Meticulous-Technologies/USB_VSense/TRADEMARK.md

# Trademark Policy

**Meticulous Technologies** and **USB VSense** are trademarks of Meticulous Technologies.

This repository offers open-source hardware and software. While the design files and source code are licensed under open-source licenses (CERN-OHL-S-2.0 and GPL-3.0-only), these licenses **do not** grant you the right to use our trademarks, trade names, or logos, except as required for reasonable attribution or as described below.

## 1. Permitted Use (Nominative Fair Use)
You may use the names "Meticulous Technologies" or "USB VSense" strictly to refer to this specific project or to describe the origin of a derivative work, provided that the use does not imply endorsement, affiliation, or sponsorship by Meticulous Technologies.

* **Allowed:** "This product is based on the USB VSense design by Meticulous Technologies."
* **Allowed:** "A fork of the USB VSense firmware."

## 2. Restricted Use (Forks and Commercial Products)
If you create a derivative work (modified hardware or software) or manufacture this design for sale:

1.  **You MUST NOT use the name "USB VSense"** as the primary name of your product. You must choose your own product name.
2.  **You MUST NOT use the "Meticulous Technologies" logo** or branding on your product, packaging, or marketing materials.
3.  **You MUST remove** the Meticulous Technologies logo and the "USB VSense" name from any physical products, software user interfaces, and marketing assets if you are distributing a modified version or a commercial product that is not authorized by us.

## 3. Manufacturing and Physical Goods
The design files in this repository (including but not limited to schematics, PCB layouts, and silkscreen / solder-mask artwork) may contain the Meticulous Technologies logo or the "USB VSense" name.

* **Personal Use:** If you manufacture these designs strictly for personal use, research, or study, you need not remove the trademarks.
* **Commercial Use:** If you manufacture these designs for sale or commercial distribution, you are **legally required to remove** all Meticulous Technologies logos and the "USB VSense" name from the physical object and the manufacturing files before production, unless you have obtained explicit written permission from us.

## 4. Third-Party Marks
The Gamma PCB artwork also contains a third-party PCB manufacturer's logo, which is not ours to license. The open-source licenses do not grant any right to it either. Remove it before manufacturing a derivative or commercial product unless you have the owner's permission.

## Summary
* **Code/Design:** Open for everyone (under CERN-OHL-S-2.0 / GPL-3.0-only).
* **Name/Brand:** Reserved for Meticulous Technologies.

If you have questions about using our marks, please contact us.
