Meticulous-Technologies/USB_VSense/firmware/MPLABX/usb_vsense_hw_gamma_fw_r1.X/queuelogs/debugtool.txt

755 1727157855812 GEN4_CONNECT_DIAGNOSTICS:MPLABCommTool is null

755 1727157855812 GEN4_TO_CONTROLLER_LOG:GEN4_CONNECT_INT_LOG_ATtiny406 Pre:GetFirmwareInfo
755 1727157855812 GEN4_TO_CONTROLLER_LOG:GEN4_CONNECT_INT_LOG_ATtiny406 Payload
755 1727157855812 GEN4_TO_CONTROLLER_LOG:GEN4_CONNECT_INT_LOG_ATtiny406 null
755 1727157855812 GEN4_TO_CONTROLLER_LOG:GEN4_CONNECT_INT_LOG_ATtiny406 Payload End
755 1727157855820 GEN4_TO_CONTROLLER_LOG:GEN4_CONNECT_INT_LOG_ATtiny406 Post:GetFirmwareInfo
755 1727157855820 GEN4_TO_CONTROLLER_LOG:GEN4_CONNECT_INT_LOG_ATtiny406 Return Value
755 1727157855820 GEN4_TO_CONTROLLER_LOG:GEN4_CONNECT_INT_LOG_ATtiny406 FirmwareInfo: Values:
755 1727157855820 GEN4_TO_CONTROLLER_LOG:GEN4_CONNECT_INT_LOG_ATtiny406 FirmwareInfo: boot = false, bootVer = 01.00.00, apVer = 02.01.35, fpgaVer = ff.ff.ff, scriptVer = 00.06.71, macAddress = 0495683578354564855485054485051, devID = a1020e01, devID1 = 2, devSN0 = ffffffff, devSN1 = ffffffff, serialNumber = BUR223271655, appCommitID = null, scriptCommitID = 74cdf38a4d, PCB_ID = 6
755 1727157855820 GEN4_TO_CONTROLLER_LOG:GEN4_CONNECT_INT_LOG_ATtiny406 Return End

755 1727157855820 GEN4_TO_CONTROLLER_LOG:GEN4_CONNECT_INT_LOG_ATtiny406 Pre:SetPowerInfo
755 1727157855820 GEN4_TO_CONTROLLER_LOG:GEN4_CONNECT_INT_LOG_ATtiny406 Payload
755 1727157855820 GEN4_TO_CONTROLLER_LOG:GEN4_CONNECT_INT_LOG_ATtiny406 PowerInfo: Values:
755 1727157855820 GEN4_TO_CONTROLLER_LOG:GEN4_CONNECT_INT_LOG_ATtiny406 PowerInfo: shotDownSystem = true, isToolPower = false, voltage = 0.000000, useVppFirst = false, useLowVoltageProgramming = true, useMaintainActivePower = false
755 1727157855820 GEN4_TO_CONTROLLER_LOG:GEN4_CONNECT_INT_LOG_ATtiny406 Payload End
755 1727157855820 XXXX 1727157855820, Thread 755: XXXX 1727157855820, Entering Thread 755: Commands::runScriptBasic with script contents. contents[0] = 0x39, ...  
755 1727157855821 XXXX 1727157855821, Thread 755: XXXX 1727157855821, Exiting Thread 755: Commands::runScriptBasic  
755 1727157855821 XXXX 1727157855821, Thread 755: XXXX 1727157855821, Entering Thread 755: Commands::runScriptBasic with script contents. contents[0] = 0x44, ...  
755 1727157855833 XXXX 1727157855833, Thread 755: XXXX 1727157855833, Exiting Thread 755: Commands::runScriptBasic  
755 1727157855833 GEN4_TO_CONTROLLER_LOG:GEN4_CONNECT_INT_LOG_ATtiny406 Post:SetPowerInfo
755 1727157855833 GEN4_TO_CONTROLLER_LOG:GEN4_CONNECT_INT_LOG_ATtiny406 Return Value
755 1727157855833 GEN4_TO_CONTROLLER_LOG:GEN4_CONNECT_INT_LOG_ATtiny406 none
755 1727157855833 GEN4_TO_CONTROLLER_LOG:GEN4_CONNECT_INT_LOG_ATtiny406 Return End
755 1727157855833 GEN4_CONNECT_DIAGNOSTICS:Removing plug and play observer com.microchip.mplab.mdbcore.RI4Tool.RI4ToolBase$RI4PlugNPlayObserver@dd39d61
755 1727157855833 GEN4_CONNECT_DIAGNOSTICS:Begin PlugNPlayObservers list dump:
755 1727157855833 GEN4_CONNECT_DIAGNOSTICS:End PlugNPlayObservers list dump:
755 1727157855883 GEN4_CONNECT_DIAGNOSTICS:Calling RIDbgToolCom.Disconnect
755 1727157855883 GEN4_CONNECT_DIAGNOSTICS:Calling MPLABCommTool.Detach to remove tool from plug and play list
755 1727157855883 GEN4_CONNECT_DIAGNOSTICS:Calling RIDbgToolCom.DisconnectFromMPlabComm
755 1727157855883 GEN4_CONNECT_DIAGNOSTICS:Calling MPLABCommTool.Disconnect
762 1727157902381 GEN4_CONNECT_DIAGNOSTICS:MPLABCommTool is NOT null
762 1727157902381 GEN4_CONNECT_DIAGNOSTICS:AttachedToolPID = 9012, AttachedToolVID = 4d8
762 1727157902381 GEN4_CONNECT_DIAGNOSTICS:transport type = USB
762 1727157902381 GEN4_CONNECT_DIAGNOSTICS:AttachedToolPID = 9012, AttachedToolVID = 4d8
762 1727157902385 com.microchip.mplab.mdbcore.RealICETool.RIDbgToolCom
762 1727157902385 GEN4_CONNECT_DIAGNOSTICS:Before MPLABCommTool.Connect()
762 1727157902386 GEN4_CONNECT_DIAGNOSTICS:After MPLABCommTool.Connect()
762 1727157902386 GEN4_CONNECT_DIAGNOSTICS:MPLABCommTool.Connect() returned MPLABCOMM_NO_ERROR
762 1727157902386 GEN4_CONNECT_DIAGNOSTICS:Attaching to MPLABCommTool plugnplay
762 1727157902386 GEN4_CONNECT_DIAGNOSTICS:Adding new plug and play observer com.microchip.mplab.mdbcore.RI4Tool.RI4ToolBase$RI4PlugNPlayObserver@465b4791
762 1727157902386 GEN4_CONNECT_DIAGNOSTICS:Begin PlugNPlayObservers list dump:
762 1727157902386 GEN4_CONNECT_DIAGNOSTICS:com.microchip.mplab.mdbcore.RI4Tool.RI4ToolBase$RI4PlugNPlayObserver@465b4791
762 1727157902386 GEN4_CONNECT_DIAGNOSTICS:End PlugNPlayObservers list dump:
762 1727157902386 GEN4_CONNECT_DIAGNOSTICS:Registering for alternate PNP notifications. CommPnPCriteria.cPIDList = [2177, 2179, 217a, 2141, 9017, 901b, 9036, 9035], CommPnPCriteria.cSerialNumber = bur223271655

762 1727157902414 GEN4_TO_CONTROLLER_LOG:GEN4_INIT_INT_LOG_ATtiny406 Pre:init
762 1727157902414 GEN4_TO_CONTROLLER_LOG:GEN4_INIT_INT_LOG_ATtiny406 Payload
762 1727157902414 GEN4_TO_CONTROLLER_LOG:GEN4_INIT_INT_LOG_ATtiny406 DeviceInfo: Values:
762 1727157902414 GEN4_TO_CONTROLLER_LOG:GEN4_INIT_INT_LOG_ATtiny406 DeviceInfo: pcAddress = 7fffffffffffffff, Vpp = 5.00, useRowEraseIfVoltageIsLow = false, voltageBelowWhichUseRowErase = 0.00, deviceName = ATtiny406, programmerType = AVR
762 1727157902414 GEN4_TO_CONTROLLER_LOG:GEN4_INIT_INT_LOG_ATtiny406 DeviceInfo: MemInfo values:
762 1727157902414 GEN4_TO_CONTROLLER_LOG:GEN4_INIT_INT_LOG_ATtiny406 DeviceInfo: mask = ffff, exists = true, startAddr = 00000000, endAddr = 00000fff, rowSize = 0040, rowEraseSize = 0040, addrInc = 0001, widthProgram = 0001
762 1727157902414 GEN4_TO_CONTROLLER_LOG:GEN4_INIT_INT_LOG_ATtiny406 DeviceInfo: mask = 00ff, exists = true, startAddr = 00821280, endAddr = 0083128a, rowSize = 0001, rowEraseSize = 0000, addrInc = 0001, widthProgram = 0001
762 1727157902414 GEN4_TO_CONTROLLER_LOG:GEN4_INIT_INT_LOG_ATtiny406 DeviceInfo: mask = 0000, exists = false, startAddr = 00000000, endAddr = 00000000, rowSize = 0000, rowEraseSize = 0000, addrInc = 0000, widthProgram = 0000
762 1727157902414 GEN4_TO_CONTROLLER_LOG:GEN4_INIT_INT_LOG_ATtiny406 DeviceInfo: mask = 00ff, exists = true, startAddr = 00001400, endAddr = 0000147f, rowSize = 0020, rowEraseSize = 0000, addrInc = 0001, widthProgram = 0001
762 1727157902414 GEN4_TO_CONTROLLER_LOG:GEN4_INIT_INT_LOG_ATtiny406 DeviceInfo: mask = 00ff, exists = true, startAddr = 00001300, endAddr = 0000131f, rowSize = 0020, rowEraseSize = 0000, addrInc = 0001, widthProgram = 0001
762 1727157902414 GEN4_TO_CONTROLLER_LOG:GEN4_INIT_INT_LOG_ATtiny406 DeviceInfo: mask = 0000, exists = false, startAddr = 00000000, endAddr = 00000000, rowSize = 0000, rowEraseSize = 0040, addrInc = 0000, widthProgram = 0000
762 1727157902414 GEN4_TO_CONTROLLER_LOG:GEN4_INIT_INT_LOG_ATtiny406 DeviceInfo: mask = 0000, exists = false, startAddr = 00000000, endAddr = 00000000, rowSize = 0000, rowEraseSize = 0000, addrInc = 0001, widthProgram = 0001
762 1727157902414 GEN4_TO_CONTROLLER_LOG:GEN4_INIT_INT_LOG_ATtiny406 DeviceInfo: mask = 0000, exists = false, startAddr = 00000000, endAddr = 00000000, rowSize = 0000, rowEraseSize = 0000, addrInc = 0000, widthProgram = 0000
762 1727157902414 GEN4_TO_CONTROLLER_LOG:GEN4_INIT_INT_LOG_ATtiny406 DeviceInfo: mask = 0000, exists = false, startAddr = 00000000, endAddr = 00000000, rowSize = 0000, rowEraseSize = 0000, addrInc = 0000, widthProgram = 0000
762 1727157902414 GEN4_TO_CONTROLLER_LOG:GEN4_INIT_INT_LOG_ATtiny406 DeviceInfo: mask = 0000, exists = false, startAddr = 00000000, endAddr = 00000000, rowSize = 0000, rowEraseSize = 0000, addrInc = 0000, widthProgram = 0000
762 1727157902414 GEN4_TO_CONTROLLER_LOG:GEN4_INIT_INT_LOG_ATtiny406 DeviceInfo: mask = 0000, exists = false, startAddr = 00000000, endAddr = 00000000, rowSize = 0000, rowEraseSize = 0000, addrInc = 0000, widthProgram = 0000
762 1727157902414 GEN4_TO_CONTROLLER_LOG:GEN4_INIT_INT_LOG_ATtiny406 DeviceInfo: mask = 0000, exists = false, startAddr = 00000000, endAddr = 00000000, rowSize = 0000, rowEraseSize = 0000, addrInc = 0001, widthProgram = 0001
762 1727157902414 GEN4_TO_CONTROLLER_LOG:GEN4_INIT_INT_LOG_ATtiny406 DeviceInfo: mask = 0000, exists = false, startAddr = 00000000, endAddr = 00000000, rowSize = 0000, rowEraseSize = 0000, addrInc = 0000, widthProgram = 0000
762 1727157902414 GEN4_TO_CONTROLLER_LOG:GEN4_INIT_INT_LOG_ATtiny406 DeviceInfo: mask = 0000, exists = false, startAddr = 00000000, endAddr = 00000000, rowSize = 0000, rowEraseSize = 0000, addrInc = 0000, widthProgram = 0000
762 1727157902414 GEN4_TO_CONTROLLER_LOG:GEN4_INIT_INT_LOG_ATtiny406 DeviceInfo: mask = 0000, exists = false, startAddr = 00000000, endAddr = 00000000, rowSize = 0000, rowEraseSize = 0000, addrInc = 0000, widthProgram = 0000
762 1727157902414 GEN4_TO_CONTROLLER_LOG:GEN4_INIT_INT_LOG_ATtiny406 DeviceInfo: mask = 0000, exists = false, startAddr = 00000000, endAddr = 00000000, rowSize = 0000, rowEraseSize = 0000, addrInc = 0000, widthProgram = 0000
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
762 1727157902414 GEN4_TO_CONTROLLER_LOG:GEN4_INIT_INT_LOG_ATtiny406 Address = 00821287, Mask = 000000ff
762 1727157902414 GEN4_TO_CONTROLLER_LOG:GEN4_INIT_INT_LOG_ATtiny406 Address = 00821288, Mask = 000000ff
762 1727157902414 GEN4_TO_CONTROLLER_LOG:GEN4_INIT_INT_LOG_ATtiny406 Address = 0083128a, Mask = 000000ff
762 1727157902414 GEN4_TO_CONTROLLER_LOG:GEN4_INIT_INT_LOG_ATtiny406 BasicInfo: Values:
762 1727157902414 GEN4_TO_CONTROLLER_LOG:GEN4_INIT_INT_LOG_ATtiny406 BasicInfo: InputStream = com.microchip.mplab.libs.toolpacksupport.EquatableFileInputStream@1fa17626, ToolFlavor = PICKit4
762 1727157902414 GEN4_TO_CONTROLLER_LOG:GEN4_INIT_INT_LOG_ATtiny406 Payload End
762 1727157902414 GEN4_TO_CONTROLLER_LOG:GEN4_INIT_INT_LOG_ATtiny406 Post:init
762 1727157902414 GEN4_TO_CONTROLLER_LOG:GEN4_INIT_INT_LOG_ATtiny406 Return Value
762 1727157902414 GEN4_TO_CONTROLLER_LOG:GEN4_INIT_INT_LOG_ATtiny406 none
762 1727157902414 GEN4_TO_CONTROLLER_LOG:GEN4_INIT_INT_LOG_ATtiny406 Return End

762 1727157902414 GEN4_TO_CONTROLLER_LOG:GEN4_INIT_INT_LOG_ATtiny406 Pre:GetInterfaceProvider
762 1727157902414 GEN4_TO_CONTROLLER_LOG:GEN4_INIT_INT_LOG_ATtiny406 Payload
762 1727157902414 GEN4_TO_CONTROLLER_LOG:GEN4_INIT_INT_LOG_ATtiny406 RI4DebugInterface
762 1727157902414 GEN4_TO_CONTROLLER_LOG:GEN4_INIT_INT_LOG_ATtiny406 Payload End
762 1727157902414 GEN4_TO_CONTROLLER_LOG:GEN4_INIT_INT_LOG_ATtiny406 Post:GetInterfaceProvider
762 1727157902414 GEN4_TO_CONTROLLER_LOG:GEN4_INIT_INT_LOG_ATtiny406 Return Value
762 1727157902414 GEN4_TO_CONTROLLER_LOG:GEN4_INIT_INT_LOG_ATtiny406 com.microchip.mplab.libs.RI4ToolsController.implementations.RI4DebugInterfaceImpl@56c82190
762 1727157902414 GEN4_TO_CONTROLLER_LOG:GEN4_INIT_INT_LOG_ATtiny406 Return End

762 1727157902414 GEN4_TO_CONTROLLER_LOG:GEN4_INIT_INT_LOG_ATtiny406 Pre:GetInterfaceProvider
762 1727157902414 GEN4_TO_CONTROLLER_LOG:GEN4_INIT_INT_LOG_ATtiny406 Payload
762 1727157902414 GEN4_TO_CONTROLLER_LOG:GEN4_INIT_INT_LOG_ATtiny406 RI4ProgramInterface
762 1727157902414 GEN4_TO_CONTROLLER_LOG:GEN4_INIT_INT_LOG_ATtiny406 Payload End
762 1727157902414 GEN4_TO_CONTROLLER_LOG:GEN4_INIT_INT_LOG_ATtiny406 Post:GetInterfaceProvider
762 1727157902414 GEN4_TO_CONTROLLER_LOG:GEN4_INIT_INT_LOG_ATtiny406 Return Value
762 1727157902414 GEN4_TO_CONTROLLER_LOG:GEN4_INIT_INT_LOG_ATtiny406 com.microchip.mplab.libs.RI4ToolsController.implementations.RI4ProgramInterfaceImpl@329074bf
762 1727157902414 GEN4_TO_CONTROLLER_LOG:GEN4_INIT_INT_LOG_ATtiny406 Return End

762 1727157902414 GEN4_TO_CONTROLLER_LOG:GEN4_INIT_INT_LOG_ATtiny406 Pre:GetInterfaceProvider
762 1727157902414 GEN4_TO_CONTROLLER_LOG:GEN4_INIT_INT_LOG_ATtiny406 Payload
762 1727157902414 GEN4_TO_CONTROLLER_LOG:GEN4_INIT_INT_LOG_ATtiny406 RI4ConnectInterface
762 1727157902414 GEN4_TO_CONTROLLER_LOG:GEN4_INIT_INT_LOG_ATtiny406 Payload End
762 1727157902414 GEN4_TO_CONTROLLER_LOG:GEN4_INIT_INT_LOG_ATtiny406 Post:GetInterfaceProvider
762 1727157902414 GEN4_TO_CONTROLLER_LOG:GEN4_INIT_INT_LOG_ATtiny406 Return Value
762 1727157902414 GEN4_TO_CONTROLLER_LOG:GEN4_INIT_INT_LOG_ATtiny406 com.microchip.mplab.libs.PK4ToolsController.PK4ConnectInterfaceImpl@2eebdab3
762 1727157902414 GEN4_TO_CONTROLLER_LOG:GEN4_INIT_INT_LOG_ATtiny406 Return End
762 1727157902416 GEN4_CONNECT_DIAGNOSTICS:acceptablePIDs = [9012, 9017, 901b, 9036, 9035]
762 1727157902416 GEN4_CONNECT_DIAGNOSTICS:otherPIDs = [2177, 2179, 217a, 2141]
762 1727157902416 GEN4_CONNECT_DIAGNOSTICS:Setting selected tool type to pk4
762 1727157902416 GEN4_CONNECT_DIAGNOSTICS:otherPIDs = [2177, 2179, 217a, 2141]
762 1727157902416 GEN4_CONNECT_DIAGNOSTICS:acceptablePIDs = [9012, 9017, 901b, 9036, 9035]

762 1727157902416 GEN4_TO_CONTROLLER_LOG:GEN4_INIT_INT_LOG_ATtiny406 Pre:GetInterfaceProvider
762 1727157902416 GEN4_TO_CONTROLLER_LOG:GEN4_INIT_INT_LOG_ATtiny406 Payload
762 1727157902416 GEN4_TO_CONTROLLER_LOG:GEN4_INIT_INT_LOG_ATtiny406 RI4ControllerDiagnosticsInterface
762 1727157902416 GEN4_TO_CONTROLLER_LOG:GEN4_INIT_INT_LOG_ATtiny406 Payload End
762 1727157902416 GEN4_TO_CONTROLLER_LOG:GEN4_INIT_INT_LOG_ATtiny406 Post:GetInterfaceProvider
762 1727157902416 GEN4_TO_CONTROLLER_LOG:GEN4_INIT_INT_LOG_ATtiny406 Return Value
762 1727157902416 GEN4_TO_CONTROLLER_LOG:GEN4_INIT_INT_LOG_ATtiny406 com.microchip.mplab.libs.RI4ToolsController.implementations.RI4ControllerDiagnosticsInterfaceImpl@63762e71
762 1727157902416 GEN4_TO_CONTROLLER_LOG:GEN4_INIT_INT_LOG_ATtiny406 Return End

762 1727157902416 GEN4_TO_CONTROLLER_LOG:GEN4_INIT_INT_LOG_ATtiny406 Pre:GetInterfaceProvider
762 1727157902416 GEN4_TO_CONTROLLER_LOG:GEN4_INIT_INT_LOG_ATtiny406 Payload
762 1727157902416 GEN4_TO_CONTROLLER_LOG:GEN4_INIT_INT_LOG_ATtiny406 ProgrammerToGo
762 1727157902416 GEN4_TO_CONTROLLER_LOG:GEN4_INIT_INT_LOG_ATtiny406 Payload End
762 1727157902416 GEN4_TO_CONTROLLER_LOG:GEN4_INIT_INT_LOG_ATtiny406 Post:GetInterfaceProvider
762 1727157902416 GEN4_TO_CONTROLLER_LOG:GEN4_INIT_INT_LOG_ATtiny406 Return Value
762 1727157902416 GEN4_TO_CONTROLLER_LOG:GEN4_INIT_INT_LOG_ATtiny406 com.microchip.mplab.libs.RI4ToolsController.implementations.ProgrammerToGoImpl@7425472e
762 1727157902416 GEN4_TO_CONTROLLER_LOG:GEN4_INIT_INT_LOG_ATtiny406 Return End

762 1727157902416 GEN4_TO_CONTROLLER_LOG:GEN4_INIT_INT_LOG_ATtiny406 Pre:GetInterfaceProvider
762 1727157902416 GEN4_TO_CONTROLLER_LOG:GEN4_INIT_INT_LOG_ATtiny406 Payload
762 1727157902416 GEN4_TO_CONTROLLER_LOG:GEN4_INIT_INT_LOG_ATtiny406 Status
762 1727157902416 GEN4_TO_CONTROLLER_LOG:GEN4_INIT_INT_LOG_ATtiny406 Payload End
762 1727157902416 GEN4_TO_CONTROLLER_LOG:GEN4_INIT_INT_LOG_ATtiny406 Post:GetInterfaceProvider
762 1727157902416 GEN4_TO_CONTROLLER_LOG:GEN4_INIT_INT_LOG_ATtiny406 Return Value
762 1727157902416 GEN4_TO_CONTROLLER_LOG:GEN4_INIT_INT_LOG_ATtiny406 null
762 1727157902416 GEN4_TO_CONTROLLER_LOG:GEN4_INIT_INT_LOG_ATtiny406 Return End
762 1727157902418 GEN4_CONNECT_DIAGNOSTICS:ENTERING: com.microchip.mplab.mdbcore.RI4Tool.ConnectionHandler.CheckForFWUpdates()
762 1727157902418 GEN4_CONNECT_DIAGNOSTICS:Created FirmwareUpdateHandler com.microchip.mplab.mdbcore.pk4hybrid.pk4hybridFirmwareUpdateHandler@45a1e099
762 1727157902418 GEN4_CONNECT_DIAGNOSTICS:ENTERING: com.microchip.mplab.mdbcore.pk4hybrid.pk4hybridFirmwareUpdateHandler.UpdateFirmware(FirmwareInfo, UpdateMessage)
762 1727157902418 GEN4_CONNECT_DIAGNOSTICS:areWeInBoot returned false
762 1727157902418 GEN4_CONNECT_DIAGNOSTICS:inBoot = false
762 1727157902418 GEN4_CONNECT_DIAGNOSTICS:uMode = checkingVersions
762 1727157902418 GEN4_CONNECT_DIAGNOSTICS:selectedTool = pk4
762 1727157902418 GEN4_CONNECT_DIAGNOSTICS:current toolType = pk4
762 1727157902418 GEN4_CONNECT_DIAGNOSTICS:current tool mode = pk4
762 1727157902418 GEN4_CONNECT_DIAGNOSTICS:ENTERING: com.microchip.mplab.mdbcore.pk4hybrid.pk4hybridFirmwareUpdateHandler.GetUpdateInfo()
762 1727157902419 GEN4_CONNECT_DIAGNOSTICS:Parsing file  for firmware updates
762 1727157902419 GEN4_CONNECT_DIAGNOSTICS:ENTERING: com.microchip.mplab.mdbcore.pk4hybrid.pk4hybridFirmwareUpdateHandler.ParseSelectedVersionsFromJamFile()
762 1727157902419 GEN4_CONNECT_DIAGNOSTICS:Jame file line = boot.hex,010000
762 1727157902419 GEN4_CONNECT_DIAGNOSTICS:Jame file line = scripts.xml,000671
762 1727157902419 GEN4_CONNECT_DIAGNOSTICS:Jame file line = app1 020135, 0040C000
762 1727157902419 GEN4_CONNECT_DIAGNOSTICS:Jame file line = app2 1.15.20, 00500000
762 1727157902419 GEN4_CONNECT_DIAGNOSTICS:Jame file line = app3 000000, FFFFFFFF
762 1727157902419 GEN4_CONNECT_DIAGNOSTICS:Jame file line = app4 000000, FFFFFFFF
762 1727157902419 GEN4_CONNECT_DIAGNOSTICS:Jame file line = app5 000000, FFFFFFFF
762 1727157902419 GEN4_CONNECT_DIAGNOSTICS:Jame file line = app6 000000, FFFFFFFF
762 1727157902419 GEN4_CONNECT_DIAGNOSTICS:Jame file line = app7 000000, FFFFFFFF
762 1727157902419 GEN4_CONNECT_DIAGNOSTICS:Jame file line = app8 000000, FFFFFFFF
762 1727157902419 GEN4_CONNECT_DIAGNOSTICS:EXITING: com.microchip.mplab.mdbcore.pk4hybrid.pk4hybridFirmwareUpdateHandler.ri4ParseSelectedVersionsFromJamFile()
762 1727157902419 GEN4_CONNECT_DIAGNOSTICS:EXITING: com.microchip.mplab.mdbcore.pk4hybrid.pk4hybridFirmwareUpdateHandler.GetUpdateInfo()
762 1727157902419 GEN4_CONNECT_DIAGNOSTICS:current toolType = pk4

762 1727157902419 GEN4_TO_CONTROLLER_LOG:GEN4_CONNECT_INT_LOG_ATtiny406 Pre:EstablishCommunincations
762 1727157902419 GEN4_TO_CONTROLLER_LOG:GEN4_CONNECT_INT_LOG_ATtiny406 Payload
762 1727157902419 GEN4_TO_CONTROLLER_LOG:GEN4_CONNECT_INT_LOG_ATtiny406 com.microchip.mplab.mdbcore.PK4Tool.PK4Com@4ca32ce1
762 1727157902419 GEN4_TO_CONTROLLER_LOG:GEN4_CONNECT_INT_LOG_ATtiny406 Payload End
762 1727157902419 GEN4_TO_CONTROLLER_LOG:GEN4_CONNECT_INT_LOG_ATtiny406 Post:EstablishCommunincations
762 1727157902419 GEN4_TO_CONTROLLER_LOG:GEN4_CONNECT_INT_LOG_ATtiny406 Return Value
762 1727157902419 GEN4_TO_CONTROLLER_LOG:GEN4_CONNECT_INT_LOG_ATtiny406 true
762 1727157902419 GEN4_TO_CONTROLLER_LOG:GEN4_CONNECT_INT_LOG_ATtiny406 Return End

762 1727157902419 GEN4_TO_CONTROLLER_LOG:GEN4_CONNECT_INT_LOG_ATtiny406 Pre:GetFirmwareInfo
762 1727157902419 GEN4_TO_CONTROLLER_LOG:GEN4_CONNECT_INT_LOG_ATtiny406 Payload
762 1727157902419 GEN4_TO_CONTROLLER_LOG:GEN4_CONNECT_INT_LOG_ATtiny406 null
762 1727157902419 GEN4_TO_CONTROLLER_LOG:GEN4_CONNECT_INT_LOG_ATtiny406 Payload End
762 1727157902427 GEN4_TO_CONTROLLER_LOG:GEN4_CONNECT_INT_LOG_ATtiny406 Post:GetFirmwareInfo
762 1727157902427 GEN4_TO_CONTROLLER_LOG:GEN4_CONNECT_INT_LOG_ATtiny406 Return Value
762 1727157902427 GEN4_TO_CONTROLLER_LOG:GEN4_CONNECT_INT_LOG_ATtiny406 FirmwareInfo: Values:
762 1727157902427 GEN4_TO_CONTROLLER_LOG:GEN4_CONNECT_INT_LOG_ATtiny406 FirmwareInfo: boot = false, bootVer = 01.00.00, apVer = 02.01.35, fpgaVer = ff.ff.ff, scriptVer = 00.06.71, macAddress = 0495683578354564855485054485051, devID = a1020e01, devID1 = 2, devSN0 = ffffffff, devSN1 = ffffffff, serialNumber = BUR223271655, appCommitID = null, scriptCommitID = 74cdf38a4d, PCB_ID = 6
762 1727157902427 GEN4_TO_CONTROLLER_LOG:GEN4_CONNECT_INT_LOG_ATtiny406 Return End
762 1727157902430 GEN4_CONNECT_DIAGNOSTICS:appNeedsUpdate returned false
762 1727157902430 GEN4_CONNECT_DIAGNOSTICS:EXITING: com.microchip.mplab.mdbcore.RI4Tool.ConnectionHandler.CheckForFWUpdates()

762 1727157902430 GEN4_TO_CONTROLLER_LOG:GEN4_CONNECT_INT_LOG_ATtiny406 Pre:EstablishCommunincations
762 1727157902430 GEN4_TO_CONTROLLER_LOG:GEN4_CONNECT_INT_LOG_ATtiny406 Payload
762 1727157902430 GEN4_TO_CONTROLLER_LOG:GEN4_CONNECT_INT_LOG_ATtiny406 com.microchip.mplab.mdbcore.PK4Tool.PK4Com@4ca32ce1
762 1727157902430 GEN4_TO_CONTROLLER_LOG:GEN4_CONNECT_INT_LOG_ATtiny406 Payload End
762 1727157902430 GEN4_TO_CONTROLLER_LOG:GEN4_CONNECT_INT_LOG_ATtiny406 Post:EstablishCommunincations
762 1727157902430 GEN4_TO_CONTROLLER_LOG:GEN4_CONNECT_INT_LOG_ATtiny406 Return Value
762 1727157902430 GEN4_TO_CONTROLLER_LOG:GEN4_CONNECT_INT_LOG_ATtiny406 true
762 1727157902430 GEN4_TO_CONTROLLER_LOG:GEN4_CONNECT_INT_LOG_ATtiny406 Return End

762 1727157902430 GEN4_TO_CONTROLLER_LOG:GEN4_CONNECT_INT_LOG_ATtiny406 Pre:GetFirmwareInfo
762 1727157902430 GEN4_TO_CONTROLLER_LOG:GEN4_CONNECT_INT_LOG_ATtiny406 Payload
762 1727157902430 GEN4_TO_CONTROLLER_LOG:GEN4_CONNECT_INT_LOG_ATtiny406 null
762 1727157902430 GEN4_TO_CONTROLLER_LOG:GEN4_CONNECT_INT_LOG_ATtiny406 Payload End
762 1727157902438 GEN4_TO_CONTROLLER_LOG:GEN4_CONNECT_INT_LOG_ATtiny406 Post:GetFirmwareInfo
762 1727157902438 GEN4_TO_CONTROLLER_LOG:GEN4_CONNECT_INT_LOG_ATtiny406 Return Value
762 1727157902438 GEN4_TO_CONTROLLER_LOG:GEN4_CONNECT_INT_LOG_ATtiny406 FirmwareInfo: Values:
762 1727157902438 GEN4_TO_CONTROLLER_LOG:GEN4_CONNECT_INT_LOG_ATtiny406 FirmwareInfo: boot = false, bootVer = 01.00.00, apVer = 02.01.35, fpgaVer = ff.ff.ff, scriptVer = 00.06.71, macAddress = 0495683578354564855485054485051, devID = a1020e01, devID1 = 2, devSN0 = ffffffff, devSN1 = ffffffff, serialNumber = BUR223271655, appCommitID = null, scriptCommitID = 74cdf38a4d, PCB_ID = 6
762 1727157902438 GEN4_TO_CONTROLLER_LOG:GEN4_CONNECT_INT_LOG_ATtiny406 Return End

762 1727157902438 GEN4_TO_CONTROLLER_LOG:GEN4_CONNECT_INT_LOG_ATtiny406 Pre:GetFirmwareInfo
762 1727157902438 GEN4_TO_CONTROLLER_LOG:GEN4_CONNECT_INT_LOG_ATtiny406 Payload
762 1727157902438 GEN4_TO_CONTROLLER_LOG:GEN4_CONNECT_INT_LOG_ATtiny406 null
762 1727157902438 GEN4_TO_CONTROLLER_LOG:GEN4_CONNECT_INT_LOG_ATtiny406 Payload End
762 1727157902445 GEN4_TO_CONTROLLER_LOG:GEN4_CONNECT_INT_LOG_ATtiny406 Post:GetFirmwareInfo
762 1727157902445 GEN4_TO_CONTROLLER_LOG:GEN4_CONNECT_INT_LOG_ATtiny406 Return Value
762 1727157902445 GEN4_TO_CONTROLLER_LOG:GEN4_CONNECT_INT_LOG_ATtiny406 FirmwareInfo: Values:
762 1727157902445 GEN4_TO_CONTROLLER_LOG:GEN4_CONNECT_INT_LOG_ATtiny406 FirmwareInfo: boot = false, bootVer = 01.00.00, apVer = 02.01.35, fpgaVer = ff.ff.ff, scriptVer = 00.06.71, macAddress = 0495683578354564855485054485051, devID = a1020e01, devID1 = 2, devSN0 = ffffffff, devSN1 = ffffffff, serialNumber = BUR223271655, appCommitID = null, scriptCommitID = 74cdf38a4d, PCB_ID = 6
762 1727157902445 GEN4_TO_CONTROLLER_LOG:GEN4_CONNECT_INT_LOG_ATtiny406 Return End
762 1727157902445 XXXX 1727157902445, Thread 762: XXXX 1727157902445, Entering Thread 762: Commands::runScriptWithUpload with script contents. contents[0] = 0x5e, ...  
762 1727157902445 XXXX 1727157902445, Thread 762: XXXX 1727157902445, Entering Thread 762: ToolCommUsb::readTransfer, sideData is 0xd bytes long, transferDataLength is 0x4 bytes long  
762 1727157902449 XXXX 1727157902449, Thread 762: XXXX 1727157902449, Exiting Thread 762: ToolCommUsb::readTransfer,  cr.status = 0x0  
762 1727157902449 XXXX 1727157902449, Thread 762: XXXX 1727157902449, Exiting Thread 762: Commands::runScriptWithUpload  
762 1727157902449 GEN4_CONNECT_DIAGNOSTICS:ENTERING: com.microchip.mplab.mdbcore.RI4Tool.ConnectionHandler.CheckForFWUpdates()
762 1727157902449 GEN4_CONNECT_DIAGNOSTICS:Created FirmwareUpdateHandler com.microchip.mplab.mdbcore.pk4hybrid.pk4hybridFirmwareUpdateHandler@45a1e099
762 1727157902449 GEN4_CONNECT_DIAGNOSTICS:ENTERING: com.microchip.mplab.mdbcore.pk4hybrid.pk4hybridFirmwareUpdateHandler.UpdateFirmware(FirmwareInfo, UpdateMessage)
762 1727157902449 GEN4_CONNECT_DIAGNOSTICS:areWeInBoot returned false
762 1727157902449 GEN4_CONNECT_DIAGNOSTICS:inBoot = false
762 1727157902449 GEN4_CONNECT_DIAGNOSTICS:uMode = done
762 1727157902449 GEN4_CONNECT_DIAGNOSTICS:selectedTool = pk4
762 1727157902450 GEN4_CONNECT_DIAGNOSTICS:current toolType = pk4
762 1727157902450 GEN4_CONNECT_DIAGNOSTICS:current tool mode = pk4
762 1727157902450 GEN4_CONNECT_DIAGNOSTICS:ENTERING: com.microchip.mplab.mdbcore.pk4hybrid.pk4hybridFirmwareUpdateHandler.updatePk4HybridFirmware()
762 1727157902450 GEN4_CONNECT_DIAGNOSTICS:Don't upgrade fimware = false
762 1727157902450 GEN4_CONNECT_DIAGNOSTICS:ENTERING: com.microchip.mplab.mdbcore.pk4hybrid.pk4hybridFirmwareUpdateHandler.updatePk4HybridFirmware()
762 1727157902450 GEN4_CONNECT_DIAGNOSTICS:EXITING: com.microchip.mplab.mdbcore.pk4hybrid.pk4hybridFirmwareUpdateHandler.UpdateFirmware(FirmwareInfo, UpdateMessage)
762 1727157902450 GEN4_CONNECT_DIAGNOSTICS:EXITING: com.microchip.mplab.mdbcore.RI4Tool.ConnectionHandler.CheckForFWUpdates()

762 1727157902450 GEN4_TO_CONTROLLER_LOG:GEN4_CONNECT_INT_LOG_ATtiny406 Pre:SetPowerInfo
762 1727157902450 GEN4_TO_CONTROLLER_LOG:GEN4_CONNECT_INT_LOG_ATtiny406 Payload
762 1727157902450 GEN4_TO_CONTROLLER_LOG:GEN4_CONNECT_INT_LOG_ATtiny406 PowerInfo: Values:
762 1727157902450 GEN4_TO_CONTROLLER_LOG:GEN4_CONNECT_INT_LOG_ATtiny406 PowerInfo: shotDownSystem = false, isToolPower = true, voltage = 5.000000, useVppFirst = false, useLowVoltageProgramming = true, useMaintainActivePower = false
762 1727157902450 GEN4_TO_CONTROLLER_LOG:GEN4_CONNECT_INT_LOG_ATtiny406 Payload End
762 1727157902450 XXXX 1727157902450, Thread 762: XXXX 1727157902450, Entering Thread 762: Commands::runScriptBasic with script contents. contents[0] = 0x39, ...  
762 1727157902451 XXXX 1727157902451, Thread 762: XXXX 1727157902451, Exiting Thread 762: Commands::runScriptBasic  
762 1727157902451 XXXX 1727157902451, Thread 762: XXXX 1727157902451, Entering Thread 762: Commands::runScriptBasic with script contents. contents[0] = 0x46, ...  
762 1727157902452 XXXX 1727157902452, Thread 762: XXXX 1727157902452, Exiting Thread 762: Commands::runScriptBasic  
762 1727157902452 XXXX 1727157902452, Thread 762: XXXX 1727157902452, Entering Thread 762: Commands::runScriptBasic with script contents. contents[0] = 0x44, ...  
762 1727157902465 XXXX 1727157902465, Thread 762: XXXX 1727157902465, Exiting Thread 762: Commands::runScriptBasic  
762 1727157902465 XXXX 1727157902465, Thread 762: XXXX 1727157902465, Entering Thread 762: Commands::runScriptBasic with script contents. contents[0] = 0x40, ...  
762 1727157902648 XXXX 1727157902648, Thread 762: XXXX 1727157902648, Exiting Thread 762: Commands::runScriptBasic  
762 1727157902648 XXXX 1727157902648, Thread 762: XXXX 1727157902648, Entering Thread 762: Commands::runScriptBasic with script contents. contents[0] = 0x47, ...  
762 1727157902653 XXXX 1727157902653, Thread 762: XXXX 1727157902653, Exiting Thread 762: Commands::runScriptBasic  
762 1727157902653 GEN4_TO_CONTROLLER_LOG:GEN4_CONNECT_INT_LOG_ATtiny406 Post:SetPowerInfo
762 1727157902653 GEN4_TO_CONTROLLER_LOG:GEN4_CONNECT_INT_LOG_ATtiny406 Return Value
762 1727157902653 GEN4_TO_CONTROLLER_LOG:GEN4_CONNECT_INT_LOG_ATtiny406 none
762 1727157902653 GEN4_TO_CONTROLLER_LOG:GEN4_CONNECT_INT_LOG_ATtiny406 Return End

762 1727157902653 GEN4_TO_CONTROLLER_LOG:GEN4_CONNECT_INT_LOG_ATtiny406 Pre:SetLEDBrightness
762 1727157902653 GEN4_TO_CONTROLLER_LOG:GEN4_CONNECT_INT_LOG_ATtiny406 Payload
762 1727157902653 GEN4_TO_CONTROLLER_LOG:GEN4_CONNECT_INT_LOG_ATtiny406 5
762 1727157902653 GEN4_TO_CONTROLLER_LOG:GEN4_CONNECT_INT_LOG_ATtiny406 Payload End
762 1727157902653 XXXX 1727157902653, Thread 762: XXXX 1727157902653, Entering Thread 762: Commands::runScriptBasic with script contents. contents[0] = 0xcf, ...  
762 1727157902655 XXXX 1727157902655, Thread 762: XXXX 1727157902655, Exiting Thread 762: Commands::runScriptBasic  
762 1727157902655 GEN4_TO_CONTROLLER_LOG:GEN4_CONNECT_INT_LOG_ATtiny406 Post:SetLEDBrightness
762 1727157902655 GEN4_TO_CONTROLLER_LOG:GEN4_CONNECT_INT_LOG_ATtiny406 Return Value
762 1727157902655 GEN4_TO_CONTROLLER_LOG:GEN4_CONNECT_INT_LOG_ATtiny406 none
762 1727157902655 GEN4_TO_CONTROLLER_LOG:GEN4_CONNECT_INT_LOG_ATtiny406 Return End

762 1727157902655 GEN4_TO_CONTROLLER_LOG:GEN4_CONNECT_INT_LOG_ATtiny406 Pre:SetToolInfo
762 1727157902655 GEN4_TO_CONTROLLER_LOG:GEN4_CONNECT_INT_LOG_ATtiny406 Payload
762 1727157902655 GEN4_TO_CONTROLLER_LOG:GEN4_CONNECT_INT_LOG_ATtiny406 ToolInfo: Values:
762 1727157902655 GEN4_TO_CONTROLLER_LOG:GEN4_CONNECT_INT_LOG_ATtiny406 ToolInfo: speedLevel = 1, PGCResistance = 4700, PGDResistance = 4700, PGCPullDir = PullDown, PGDPullDir = PullDown, ICSPSelected = Wire2
762 1727157902655 GEN4_TO_CONTROLLER_LOG:GEN4_CONNECT_INT_LOG_ATtiny406 Payload End
762 1727157902655 XXXX 1727157902655, Thread 762: XXXX 1727157902655, Entering Thread 762: Commands::runScriptBasic, script name = SetSpeed, timeOut = -1 ms  
762 1727157902656 XXXX 1727157902656, Thread 762: XXXX 1727157902656, Exiting Thread 762: Commands::runScriptBasic  
762 1727157902656 XXXX 1727157902656, Thread 762: XXXX 1727157902656, Entering Thread 762: Commands::runScriptBasic, script name = EnterProgMode, timeOut = -1 ms  
762 1727157902984 XXXX 1727157902984, Thread 762: XXXX 1727157902984, Exiting Thread 762: Commands::runScriptBasic  
762 1727157902984 GEN4_TO_CONTROLLER_LOG:GEN4_CONNECT_INT_LOG_ATtiny406 Post:SetToolInfo
762 1727157902984 GEN4_TO_CONTROLLER_LOG:GEN4_CONNECT_INT_LOG_ATtiny406 Return Value
762 1727157902984 GEN4_TO_CONTROLLER_LOG:GEN4_CONNECT_INT_LOG_ATtiny406 none
762 1727157902984 GEN4_TO_CONTROLLER_LOG:GEN4_CONNECT_INT_LOG_ATtiny406 Return End

762 1727157902984 GEN4_TO_CONTROLLER_LOG:GEN4_CONNECT_INT_LOG_ATtiny406 Pre:GetTargetIDInfo
762 1727157902984 GEN4_TO_CONTROLLER_LOG:GEN4_CONNECT_INT_LOG_ATtiny406 Payload
762 1727157902984 GEN4_TO_CONTROLLER_LOG:GEN4_CONNECT_INT_LOG_ATtiny406 null
762 1727157902984 GEN4_TO_CONTROLLER_LOG:GEN4_CONNECT_INT_LOG_ATtiny406 Payload End
762 1727157902986 XXXX 1727157902986, Thread 762: XXXX 1727157902986, Entering Thread 762: Commands::runScriptBasic, script name = EnterProgMode, timeOut = -1 ms  
762 1727157903622 XXXX 1727157903622, Thread 762: XXXX 1727157903622, Exiting Thread 762: Commands::runScriptBasic
