Meticulous-Technologies/USB_VSense/docs/schematics/USB_VSense_r1.pdf

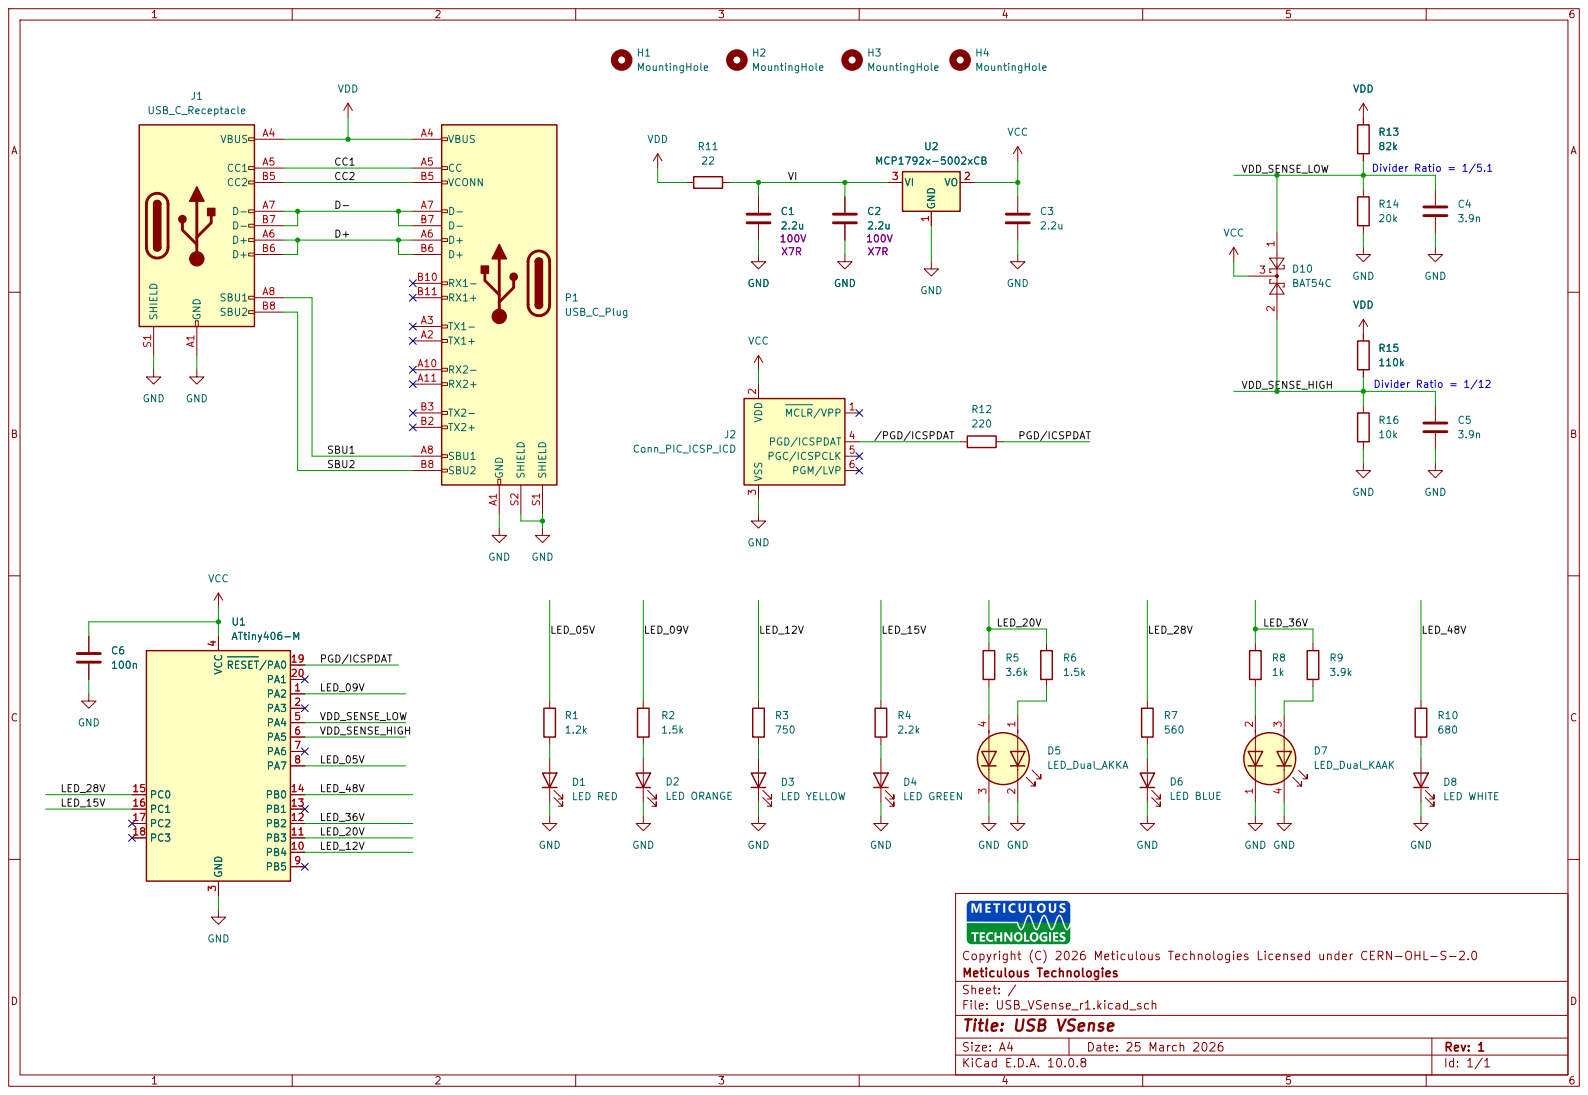
[picture p3: page 1]

Divider Ratio = 1/5.1 Divider Ratio = 1/12 GND

3 PGD/ICSPDAT 4 PGC/ICSPCLK 5 PGM/LVP 6

Copyright (C) 2026 Meticulous Technologies Licensed under CERN-OHL-S-2.0
Meticulous Technologies
Sheet: /
File: USB_VSense_r1.kicad_sch
Title: USB VSense

Size: A4 | Rev: 1
KiCad E.D.A. 10.0.8 | Id: 1/1
