Meticulous-Technologies/USB_VSense/docs/schematics/USB_VSense_gamma.pdf

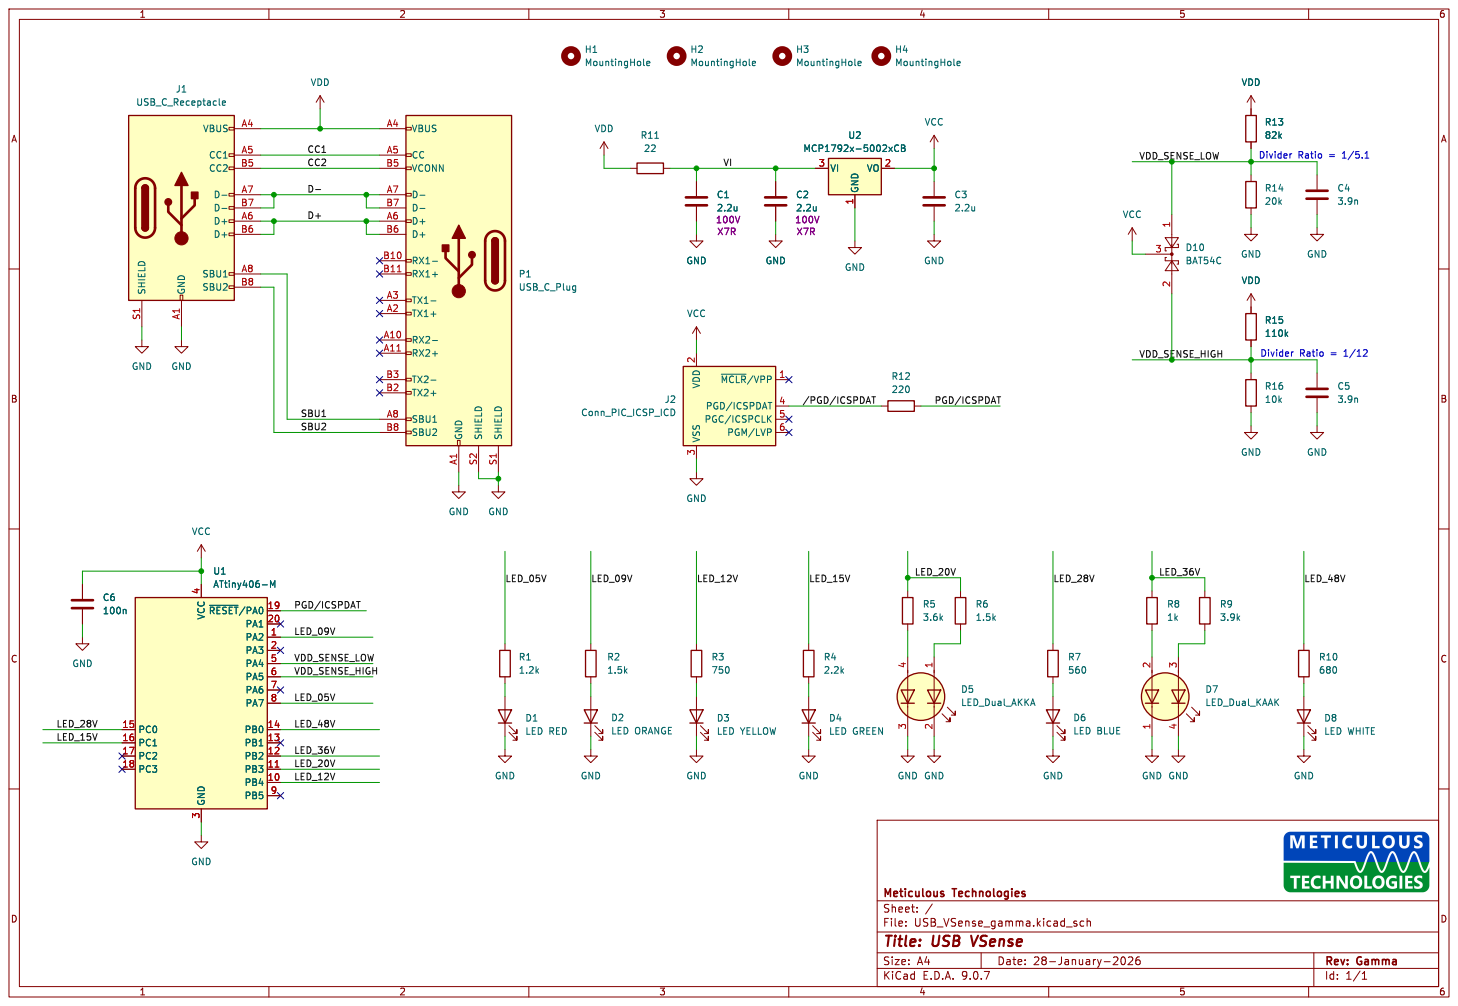
[picture p4: page 1]

Divider Ratio = 1/5.1 Divider Ratio = 1/12 GND

2 D10 BAT54C GND GND GND GND GND

3 ~{MCLR}/VPP1 PGD/ICSPDAT 4 PGC/ICSPCLK 5 PGM/LVP 6

Id: 1/1 Title: USB VSense
