Meticulous-Technologies/USB_VSense/hardware/KiCAD/USB_VSense_gamma/USB_VSense_gamma.kicad_sch

## KiCad design hardware/KiCAD/USB_VSense_gamma/USB_VSense_gamma.kicad_sch (2026-01-29)

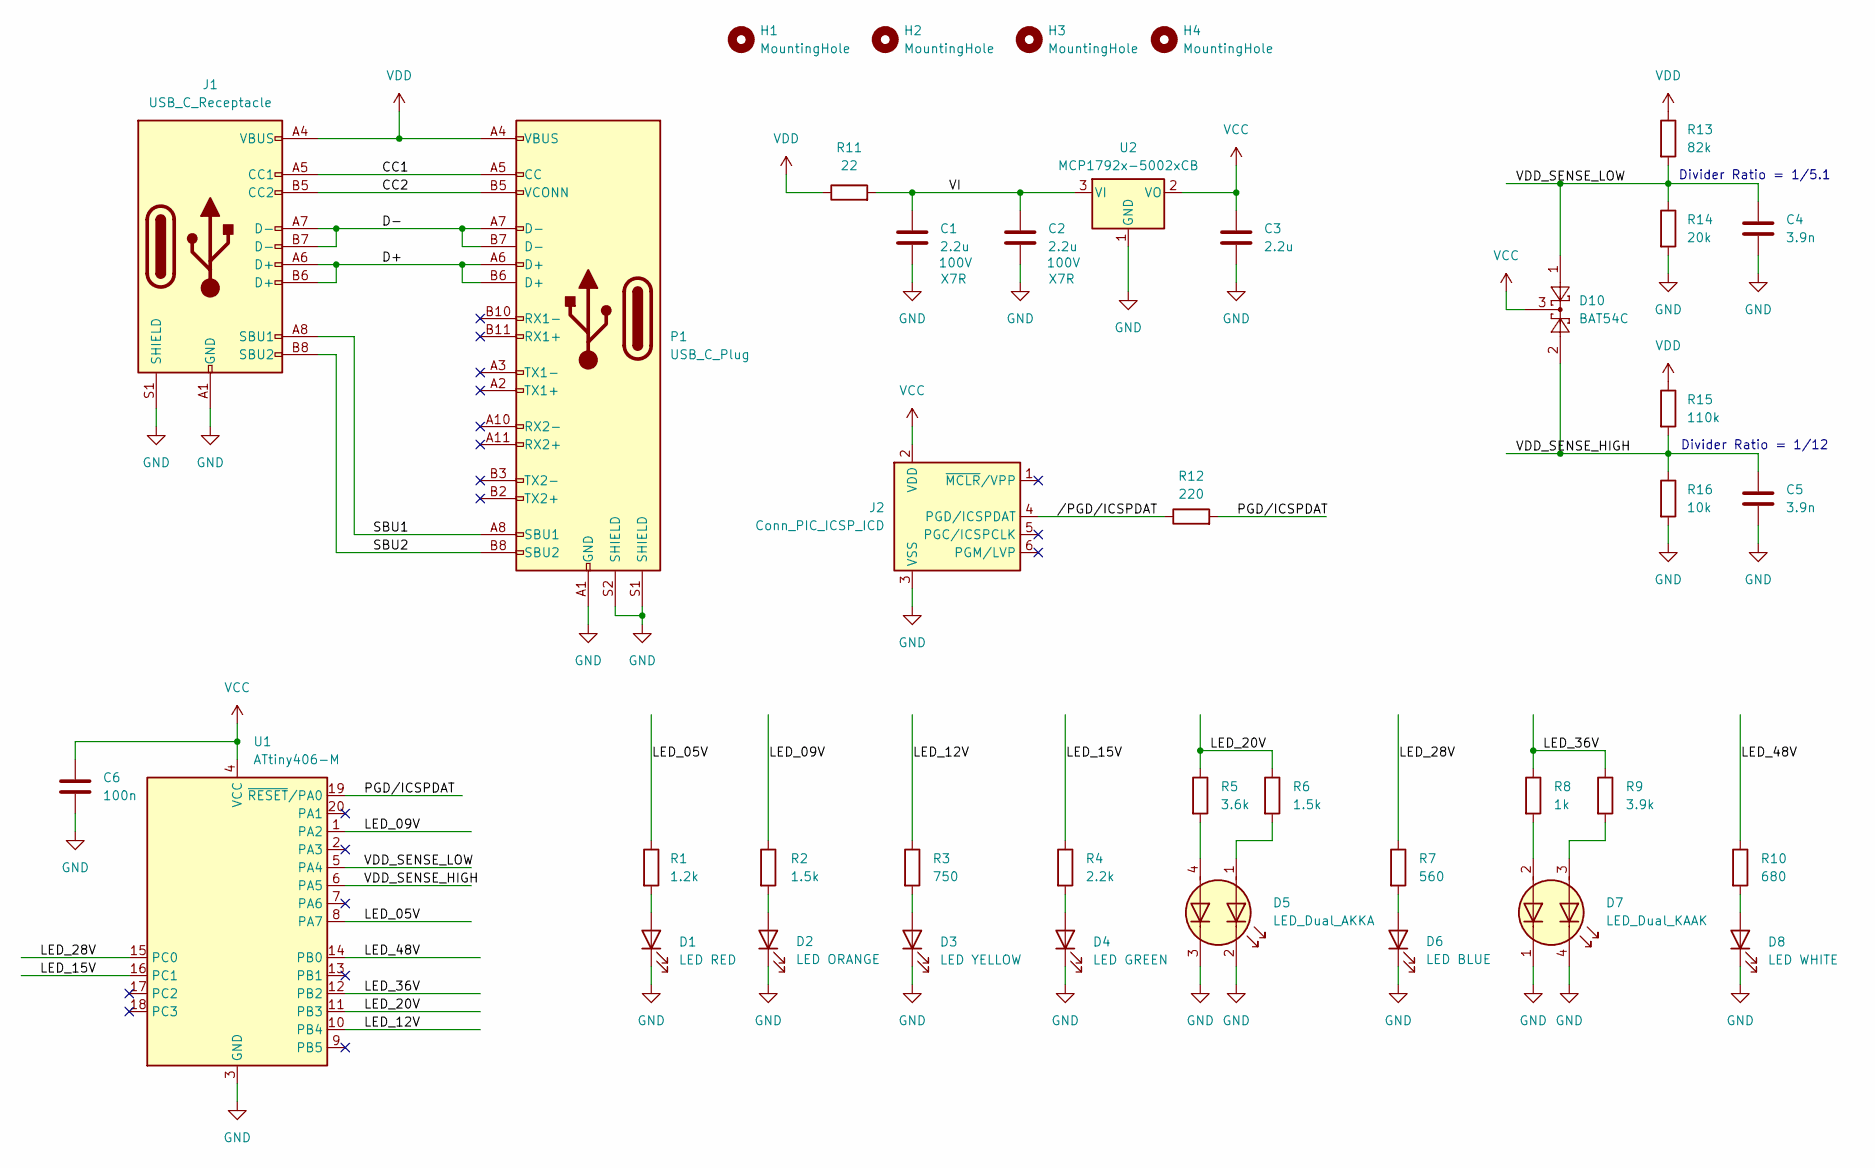
[picture p5: schematic USB_VSense_gamma.kicad_sch]

Parts:
C1, C2: 2.2u; C_0805_2012Metric; Voltage Rating 100V; Mfg Part # GRM21BD72A225KE01L
C3: 2.2u; C_0805_2012Metric; Voltage Rating 16V; Mfg Part # CL21B225KOFNNNE
C4, C5: 3.9n; C_0603_1608Metric; Voltage Rating 16V; Mfg Part # C0603C392K4RAC7867
C6: 100n; C_0603_1608Metric; Voltage Rating 16V; Mfg Part # CL10B104KO8NNNC
D1: LED RED; LED_0603_1608Metric; Mfg Part # APT1608LSECK/J3-PRV
D2: LED ORANGE; LED_0603_1608Metric; Mfg Part # APT1608LSECK/J4-PRV
D3: LED YELLOW; LED_0603_1608Metric; Mfg Part # APT1608LSYCK/J3-PRV
D4: LED GREEN; LED_0603_1608Metric; Mfg Part # APT1608LZGCK
D5: LED_Dual_AKKA; LED_Kingbright_APHBM2012_2x1.25mm; Mfg Part # APHBM2012LVBDZGKC
D6: LED BLUE; LED_0603_1608Metric; Mfg Part # APT1608LVBC/D
D7: LED_Dual_KAAK; LED_Kingbright_APHBM2012_2x1.25mm; Mfg Part # APHBM2012LVBDSEKJ3C
D8: LED WHITE; LED_0603_1608Metric; Mfg Part # LW Q38E-Q1OO-3K6L-1-5-R18
D10: BAT54C; SOT-23
H1, H2, H3, H4: MountingHole; Mounting_Wuerth_WA-SMSI-M1.6_H1.5mm_9774015633; Mfg Part # 9774015633R
J1: USB_C_Receptacle; USB_C_Receptacle_JAE_DX07S016JA1R1500; Mfg Part # DX07S016JA1R1500
J2: Conn_PIC_ICSP_ICD; Conn_AVR_UPDI
P1: USB_C_Plug; USB_C_Plug_JAE_DX07P024AJ5; Mfg Part # DX07P024AJ5R1500
R1: 1.2k; R_0603_1608Metric; Tolerance 1%; Mfg Part # RC0603FR-071K2L
R2, R6: 1.5k; R_0603_1608Metric; Tolerance 1%; Mfg Part # RC0603FR-071K5L
R3: 750; R_0603_1608Metric; Tolerance 1%; Mfg Part # RC0603FR-07750RL
R4: 2.2k; R_0603_1608Metric; Tolerance 1%; Mfg Part # RC0603FR-072K2L
R5: 3.6k; R_0603_1608Metric; Tolerance 1%; Mfg Part # RC0603FR-073K6L
R7: 560; R_0603_1608Metric; Tolerance 1%; Mfg Part # RC0603FR-07560RL
R8: 1k; R_0603_1608Metric; Tolerance 1%; Mfg Part # RC0603FR-071KL
R9: 3.9k; R_0603_1608Metric; Tolerance 1%; Mfg Part # RC0603FR-073K9L
R10: 680; R_0603_1608Metric; Tolerance 1%; Mfg Part # RC0603FR-07680RL
R11: 22; R_0805_2012Metric; Mfg Part # RC0805FR-0722RL
R12: 220; R_0603_1608Metric; Tolerance 1%; Mfg Part # RC0603FR-07220RL
R13: 82k; R_0603_1608Metric; Tolerance 1%; Mfg Part # RC0603FR-0782KL
R14: 20k; R_0603_1608Metric; Tolerance 1%; Mfg Part # RC0603FR-0720KL
R15: 110k; R_0603_1608Metric; Tolerance 1%; Mfg Part # RC0603FR-07110KL
R16: 10k; R_0603_1608Metric; Tolerance 1%; Mfg Part # RC0603FR-0710KL
U1: ATtiny406-M; VQFN-20-1EP_3x3mm_P0.4mm_EP1.7x1.7mm; Mfg Part # ATTINY406-MNR
U2: MCP1792x-5002xCB; SOT-23A; Mfg Part # MCP1792T-5002H/CB

Connections:
CC1: J1.A5 (CC1), P1.A5 (CC)
CC2: J1.B5 (CC2), P1.B5 (VCONN)
D+: J1.A6 (D+), J1.B6 (D+), P1.A6 (D+), P1.B6 (D+)
D-: J1.A7 (D-), J1.B7 (D-), P1.A7 (D-), P1.B7 (D-)
GND: C1.2, C2.2, C3.2, C4.2, C5.2, C6.2, D1.1 (K), D2.1 (K), D3.1 (K), D4.1 (K), D5.2 (K1), D5.3 (K2), D6.1 (K), D7.1 (K1), D7.4 (K2), D8.1 (K), J1.A1 (GND), J1.A12 (GND), J1.B1 (GND), J1.B12 (GND), J1.S1 (SHIELD), J2.3 (VSS), P1.A1 (GND), P1.A12 (GND), P1.B1 (GND), P1.B12 (GND), P1.S1 (SHIELD), P1.S2 (SHIELD), R14.2, R16.2, U1.3 (GND), U1.21 (GND), U2.1 (GND)
LED_05V: R1.1, U1.8 (PA7)
LED_09V: R2.1, U1.1 (PA2)
LED_12V: R3.1, U1.10 (PB4)
LED_15V: R4.1, U1.16 (PC1)
LED_20V: R5.1, R6.1, U1.11 (PB3)
LED_28V: R7.1, U1.15 (PC0)
LED_36V: R8.1, R9.1, U1.12 (PB2)
LED_48V: R10.1, U1.14 (PB0)
unnamed: D1.2 (A), R1.2
unnamed: D2.2 (A), R2.2
unnamed: D3.2 (A), R3.2
unnamed: D4.2 (A), R4.2
unnamed: D5.1 (A1), R6.2
unnamed: D5.4 (A2), R5.2
unnamed: D6.2 (A), R7.2
unnamed: D7.2 (A1), R8.2
unnamed: D7.3 (A2), R9.2
unnamed: D8.2 (A), R10.2
PGD/ICSPDAT: R12.2, U1.19 (~RESET/PA0)
SBU1: J1.A8 (SBU1), P1.A8 (SBU1)
SBU2: J1.B8 (SBU2), P1.B8 (SBU2)
VCC: C3.1, C6.1, D10.3, J2.2 (VDD), U1.4 (VCC), U2.2 (VO)
VDD: J1.A4 (VBUS), J1.A9 (VBUS), J1.B4 (VBUS), J1.B9 (VBUS), P1.A4 (VBUS), P1.A9 (VBUS), P1.B4 (VBUS), P1.B9 (VBUS), R11.1, R13.1, R15.1
VDD_SENSE_HIGH: C5.1, D10.2, R15.2, R16.1, U1.6 (PA5)
VDD_SENSE_LOW: C4.1, D10.1, R13.2, R14.1, U1.5 (PA4)
VI: C1.1, C2.1, R11.2, U2.3 (VI)
/PGD/ICSPDAT: J2.4 (PGD/ICSPDAT), R12.1

Notes on the sheet:
Divider Ratio = 1/5.1
Divider Ratio = 1/12
