Meticulous-Technologies/USB_VSense/(commit log)

2026-01-28 folder name change
    [005_usb_volt_tester_beta.kicad_pcb_bom.csv, 005_usb_volt_tester_beta.kicad_pcb_positions.csv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]
2026-01-29 add firmware
    [USB_VSense_gamma.kicad_sch]
2026-01-29 added schematics
2026-01-29 final changes
    [USB_VSense_gamma.kicad_pcb, USB_VSense_gamma.kicad_sch]
2026-11-11 Add Rev. 1 hardware, firmware v1.2 and production files; repo cleanup
    - production/rev1: fabricated Gerbers, complete BOM, firmware HEX + SHA-256
    - Firmware v1.2 (usb_vsense_r1_2.X): builds on current XC8, byte-identical HEX to the production build
    - Rev. 1 KiCad project; both projects now KiCad 10; library renamed to USB_VSense
    - README, NOTICE, .gitignore, .gitattributes (Gerbers/HEX stored byte-exact)
    - Remove old firmware project, backups, caches, stale outputs, unused footprints, build output
2026-11-11 Rev. 1: 2-layer enclosure set, fab/PCBA/assembly notes, remove wrong r1 schematic PDF
    Claude-Session: https://claude.ai/code/session_01LFmYTPnYMpWACVYBmkRutq
2026-11-11 Restore Gamma pcbway_logo footprint; clear stale 005 footprint field in USB_C_Plug symbol
    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
2026-11-12 Rewrite docs for the Rev. 1 release; add placement file; clean BOM
    READMEs rewritten for builders and users. BOM: one MPN per part plus alternatives, C4/C5 manufacturer fixed, main PCB size corrected, M1.6 x 5 mm wafer-head screws specified. Add main-board placement file (positions verified identical to Rev. 1, R5/R6 values matched to BOM). Remove stale generated files (Gamma iBOM showed wrong R5/R6; schematic CSV exports outdated). Document the drill/Gerber origin offset in the as-manufactured files.
    Claude-Session: https://claude.ai/code/session_01LFmYTRRrUUEVZoDs1uriGL
2026-11-12 Sync PCBs with schematics; add Rev. 1 schematic PDF; schematic PDFs under CERN-OHL-S
    Update PCB from Schematic on Gamma and Rev. 1: R5 3.6k, R6 1.5k and C6 MPN now match the schematic (the PCB Value fields had been stale since 2024; built boards always used the schematic values). Rev. 1 CE/UKCA/WEEE logos marked 'Not in schematic'. Teardrops regenerated by KiCad; tracks, vias, zones and outlines unchanged. Rev. 1 title block gains the copyright/licence line. New schematic PDFs for Rev. 1 and Gamma in docs/schematics/, licensed CERN-OHL-S-2.0 (LICENSE, NOTICE, README updated).
    Claude-Session: https://claude.ai/code/session_01LFmYTRRrUUE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
