Meticulous-Technologies/USB_VSense/(notices)

Notices in the files:
firmware/MPLABX/usb_vsense_r1_2.X/main.c:
This program is free software: you can redistribute it and/or modify
it under the terms of the GNU General Public License as published by
the Free Software Foundation, either version 3 of the License, or
(at your option) any later version.
firmware/MPLABX/usb_vsense_r1_2.X/gpio.h:
the Free Software Foundation, version 3 of the License.
hardware/KiCAD/USB_VSense_gamma/USB_VSense_gamma.kicad_pcb:
License: CERN-OHL-S-2.0
